gbox3d/bleuno/_forAI/plan.md

# Plan

## 목차

- [Current goal](#current-goal)
- [Near-term work](#near-term-work)
- [Structure decisions](#structure-decisions)
- [Risks](#risks)

## Current goal

사용자는 수업 구성을 뒤로 미루고 type_m 완성을 우선한다. 보고된 문제는 **USB로는 부팅되지만 배터리로는 부팅되지 않는 것**이며, 사용자는 먼저 KiCad 설계 자체를 검토·수정하라고 요청했다. 2026-11-01에 **v1.1 전원부 설계 오류 3건(BAT 극성 표시, J2 직렬 스위치, J1 이름)을 수정·검증했다.** 다음 세션은 아래 남은 결정과 실물 검증 준비부터 이어간다.

센서 배선과 전원부는 v1.1 설계 파일에서 수정 완료했고 펌웨어/앱은 1.1.0이다. 새 승압 회로 추가, 펌웨어 변경/업로드, PCB 제작은 수행하지 않았다. 설계 수정이 실장된 v1 보드를 고치지는 않는다.

## Near-term work

- [x] 2026-11-01 전원 설계 검토 자료를 읽고 KiCad 작업본을 확인했다.
- [x] 2026-11-01 **배터리 극성 표시 수정.** 실크 `BAT + -` → `BAT`(원위치) + 각 패드 바로 위 `−`(J1.2 GND)/`+`(J1.1) 0.8 mm. 패드 네트는 바꾸지 않았다.
- [x] 2026-11-01 **전원 스위치 직렬화.** J1.1 VCC→VIN, J2.3(VIN)으로 1.0 mm 배선 추가, VCC 노드로 가던 대각 배선 삭제, 회로도 #PWR012 제거·VIN 라벨·J2.1 NC. 결과 VIN={J1.1,J2.3}, VCC={J2.2,J5.1,J6.1,R1.1,U1.8,U2.9}.
- [x] 2026-11-01 **J1 값 `MT1`→`BAT`** (회로도·PCB).
- [x] 2026-11-01 수정 후 kicad-cli netlist/ERC/DRC(회로도 일치)·독립 대조 `verify_power_fix.py` 34/34 PASS. 규칙·핀 유형 완화 없음. CHKBAT 분압은 VCC 쪽 유지(ON이면 배터리 전압/2, OFF이면 무전류). 전후 그림 `validation/power-fix-2026-11-01/review.html`.
- [ ] **J2에 꽂을 부품을 정한다.** 소형 슬라이드 스위치(SS12D00 계열 0.3–0.5 A)는 모터·서보 피크 전류에 부족할 수 있다. 부하 전류 예산(DRV8833 모터 2개 + 서보 2개 + MCU)을 정하고, 그 전에는 2–3 쇼트 점퍼로 운용한다. 사용자에게 사양을 반복해 묻지 말고 먼저 부품 자료로 예산 초안을 만든다.
- [ ] **USB·배터리 동시 연결 정책을 정한다.** 판매자 매뉴얼은 모듈 5V 핀 입력 5 V±0.2 V·Type-C와 5V 핀 동시 급전 금지를 명시한다. 배터리 연결+스위치 ON 상태로 USB를 꽂지 않는 운용 규칙을 교재·앱 안내에 반영할지 결정한다. 모듈의 USB→5V 핀 경로는 KiCad에 없으므로 단정하지 않는다.
- [ ] **실장된 v1 보드의 처리를 정한다.** v1은 배터리가 VCC에 직결되고 SEN1이 미연결이다. 재제작(v1.1) 또는 임시 보수 중 무엇을 할지는 사용자 결정이며, 점퍼를 기본 절차처럼 요구하지 않는다.
- [ ] 전원 구성의 판정 한계: 3.7 V 직결 불가·승압 필수·실제 역극성·부품 손상을 현재 정보로 단정하지 않는다. 배터리 부팅 실패 원인은 미확정이다.
- [ ] 전원부 결정 뒤 DHT22 정상 수치 확인을 이어간다. 현재 DHT22는 SENSOR1에 연결됐으나 실제 수치 성공 기록은 없다.
- [ ] 남은 ERC 오류20(no_connect 미표시 미연결 핀 5: U1 GPIO2/8/9/21·U2 ULT, 전원 심볼 미구동 2: VCC·GND, 가져온 심볼의 Input 핀 유형 pin_not_driven 13)/경고26(pin_to_pin)과 실크 높이 DRC 경고12를 검토한다. 핀 유형을 실제 기능대로 고치거나 PWR_FLAG를 두는 것은 사용자 결정 뒤에 한다. 제작 출력·실물 부하·파형 검증은 완료로 표시하지 않는다.
- [ ] 제작 전 최종 점검: 제작 출력(Gerber/드릴) 생성과 BOM(J2 부품 포함) 정리. 그 뒤 모터 정지/방향·서보 파형/부하 확인 범위를 정한다.

## Structure decisions

- 현재 수정 작업본: `hardware/type_m/v1.1/kicad/type_m_v1_1.kicad_pro`. 원본 `hardware/type_m/v1/`과 원본 아카이브는 보존한다. **v1.1은 제작 전이므로 센서 배선과 전원부 수정을 같은 리비전으로 관리한다.** 센서 단계만의 스냅샷은 `validation/power-fix-2026-11-01/before-power-fix.*`에 있어 필요하면 v1.1(센서)/v1.2(전원)로 나눌 수 있다.
- v1.1 SEN1 배선: J7.2–R3.2–U1.15(GPIO20), 기존 J7 3.3V와 R3 10kΩ 유지. U1.16 이름은 GPIO21, 미연결이다. 하드웨어 리비전은 펌웨어 버전과 독립적이다.
- v1.1 전원부: 배터리 + → J1.1 → VIN → J2.3; J2.2(COM) → VCC → U1.8/U2.9/J5.1/J6.1/R1.1; J2.1 OFF/NC. CHKBAT 분압은 VCC 쪽. 설계 파일 수정은 스크립트(`patch_*_power.py`)로 적용했고 수정 전 해시와 다르면 재실행을 거부한다.
- 펌웨어: `src/type_m_main.cpp` / `include/type_m_protocol.hpp`, 별도 PlatformIO `type_m`, 버전1.1.0, DHT11/22. 기존 LED/DHT11 `src/main.cpp` 및 JSON Config와 혼합하지 않는다.
- Android 완성 앱: `C:\Users\user\Desktop\work\cronos\bleunoApp\TypeMControl`. 교재: `C:\Users\user\Desktop\work\teaching_repo\android_programming`. type_m 완성 이후 수업 배치·단계별 과제를 논의한다.
- type_s 작업은 보류다. 기존 이전 결과·R1/R2 값 차이는 보존한다.
- 이번 세션에서 외부 EasyEDA 원본은 수정하지 않았다. 후속 작업은 사용자 요청대로 KiCad를 우선한다. 제조 주문·게시·commit/push는 수행하지 않았다.

## Risks

- **사용자에게 작업을 시키기 전에 보드를 확인한다.** 사용자는 “키캐드만 보세요”, “시키지좀 마세요..보드 확인 부터 해요”라고 명시했다. 같은 측정·점퍼·배터리/부하 사양 질문을 반복하지 않는다.
- “배터리3.7V”와 이후 “4.9V가 나온다”는 보고가 있다. 측정 위치/전원 모듈 포함 여부는 미확정이다. 낮은 전압이 원인이라고 몰아가거나 승압 회로를 먼저 확정하지 않는다.
- BAT 실크의 극성 순서가 잘못됐지만 사용자의 실제 연결이 역극성이었는지는 미확정이다. BAT→U1 구리 배선은 존재하므로 전원 배선 누락이라고 설명하지 않는다.
- KiCad의 U1 전원 핀 이름과 PCB pad/net은 대응한다. 그러나 풋프린트에는 5V/GND/3V3 실제 모듈 핀 실크가 없고 모듈 내부 회로도 없다. 외부 실물 특성까지 확인했다고 주장하지 않는다.
- v1.1 센서 파일 수정은 실장된 v1을 자동 수리하지 않는다. 물리 보수 여부·정상 DHT 측정·부하 구동은 미확정이다.
- `normalize_import.py` 등 원본 이전용 스크립트를 후속 설계에 자동 재실행하지 않는다. `patch_pcb_sensor.py`는 이미 적용됐으며 재적용하지 않는다.
- Python은 기존 인터프리터+uv만 사용하고 자동 다운로드를 금지한다. 기존 Flash 백업과 미커밋 작업을 보존한다.
