gbox3d/bleuno/hardware/type_m/v1/pinmap.md

# BLEuno type_m v1 — 원본 회로와 핀맵

## 목차

- [확인 범위](#확인-범위)
- [부품 대응](#부품-대응)
- [MCU 핀맵](#mcu-핀맵)
- [DRV8833 모듈 핀맵](#drv8833-모듈-핀맵)
- [커넥터와 전원](#커넥터와-전원)
- [원본에서 확인한 미연결과 불확정 사항](#원본에서-확인한-미연결과-불확정-사항)
- [기존 교재와의 차이](#기존-교재와의-차이)

## 확인 범위

대상은 `MovingTarget` 프로젝트의 `MotorConT1` 보드다.
원본 [MovingTarget_MotorConT1_2026-10-31.epro](source/MovingTarget_MotorConT1_2026-10-31.epro)의 회로도 심볼·핀 좌표·NET 속성과 PCB의 PAD_NET 레코드를 읽었다.
실장 부품 12개, 부품 핀 52개의 네트 대응은 두 문서에서 일치했다. 보드의 별도 홀 패드 2개는 이 부품 핀 수에 포함하지 않는다.

이 문서의 핀 번호와 네트 이름은 **원본 설계에서 관찰한 값**이다. 실제 부품 핀아웃·전압 허용범위·제작 보드의 동작까지 검증한 값은 아니다.
KiCad 이전을 마쳤다. 참조명·라이브러리 연결과 가져오기 결과를 정리한 뒤 원본과 대조했으며, 회로 기능을 바꾸는 수정은 하지 않았다.
원본 설계의 전기적 미연결과 모듈 핀 표기 검토는 남아 있다. [README](README.md)와 [이전 비교 결과](validation/import-comparison.json)를 함께 확인한다.

이전 비교에서는 부품 12개·부품 패드 52개·트랙 118개·비아 0개·연결 네트 그룹 17개가 일치했다.
별도 홀 패드 2개는 KiCad에서 `MP1`, `MP2`로 관리한다. 이 수치 일치는 회로 동작이나 제작 가능성을 보증하지 않는다.

원본 내부 경로:

- `PCB/230020836b7d42a2ae0bd4e6ece12948.epcb`
- `SHEET/dd2cfae3a64d4b3db5dd5a512ac44bc2/1.esch`
- MCU 심볼: `SYMBOL/ef7b01f3d1c740a3922ade97e6567549.esym`
- 드라이버 심볼: `SYMBOL/05bd6a162ddc49aa8801eba8ecf4b81c.esym`

## 부품 대응

원본 참조명에는 중복·공백·개행이 있다. 아래 표는 KiCad에서 정리한 참조명과 원본 이름의 대응이다.

| 원본 이름 | KiCad 정리 대응명 | 역할 |
|---|---|---|
| Tenstar | U1 | ESP32-C3 Supermini 모듈 |
| DRV8833 | U2 | 12핀 모터 드라이버 모듈 |
| 220k — VCC 쪽 | R1 | VCC와 CHKBAT 사이 220kΩ |
| 220k — GND 쪽 | R2 | CHKBAT와 GND 사이 220kΩ |
| 10k | R3 | 3.3V와 SEN1 사이 10kΩ 풀업. `project.json`의 라이브러리 기본값을 상속 |
| BAT + - | J1 | 전원 커넥터 |
| PW OFF ON | J2 | 3핀 헤더 |
| MT1 | J3 | 모터 출력 1 |
| MT2 | J4 | 모터 출력 2 |
| Servo1 | J5 | 서보 출력 1 |
| Servo2 | J6 | 서보 출력 2 |
| sensor1 | J7 | 센서용 3핀 커넥터 |

## MCU 핀맵

`Tenstar` 모듈의 **심볼·풋프린트 핀 번호**를 기준으로 한다. ESP32-C3 칩 패키지의 핀 번호가 아니다.

| 모듈 핀 | 원본 심볼 이름 | 네트 | 연결 |
|---|---|---|---|
| 1 | GPIO0 | CHKBAT | 배터리 전압 감지용 분압 중간점 |
| 2 | GPIO1 | D1 | DRV8833 모듈 pin7, IN1 |
| 3 | GPIO2 | 없음 | 미연결 |
| 4 | GPIO3 | D2 | DRV8833 모듈 pin8, IN2 |
| 5 | GPIO4 | D3 | DRV8833 모듈 pin11, IN3 |
| 6 | +3V3 | 3.3V | sensor1 전원과 R3 풀업 |
| 7 | GND | GND | 공통 접지 |
| 8 | +5V | VCC | 배터리·드라이버·서보 전원과 같은 네트 |
| 9 | GPIO5 | D4 | DRV8833 모듈 pin12, IN4 |
| 10 | GPIO6 | SERVO1 | Servo1 pin2 |
| 11 | GPIO7 | SLEEP | DRV8833 모듈 pin1 |
| 12 | GPIO8 | 없음 | 미연결 |
| 13 | GPIO9 | 없음 | 미연결 |
| 14 | GPIO10 | SERVO2 | Servo2 pin2 |
| 15 | GPIO21 | 없음 | 미연결. 실제 모듈 핀 이름 대조 필요 |
| 16 | GPIO22 | 없음 | 원본 심볼의 표기. 실제 모듈 핀 이름 대조 필요 |

`GPIO22`라는 문자열은 원본 심볼에서 그대로 옮긴 것이며 실제 ESP32-C3 모듈의 GPIO로 확정하지 않는다.
원본에 함께 들어 있는 다른 Supermini 심볼은 이 보드에 사용되지 않았으므로 대체 근거로 삼지 않았다.

## DRV8833 모듈 핀맵

이 심볼은 **12핀 모듈**이다. DRV8833 IC 단품 심볼로 바꾸면서 같은 번호를 적용하면 안 된다.
`EEP`, `ULT`는 원본에 적힌 핀 이름이며 실제 모듈의 SLEEP·FAULT 표시와 대조가 필요하다.

| 모듈 핀 | 원본 핀 이름 | 네트 | 연결 |
|---|---|---|---|
| 1 | EEP | SLEEP | MCU GPIO7 |
| 2 | OUT1 | OUT1 | MT1 pin1 |
| 3 | OUT2 | OUT2 | MT1 pin2 |
| 4 | OUT3 | OUT3 | MT2 pin1 |
| 5 | OUT4 | OUT4 | MT2 pin2 |
| 6 | ULT | 없음 | 미연결 |
| 7 | IN1 | D1 | MCU GPIO1 |
| 8 | IN2 | D2 | MCU GPIO3 |
| 9 | VCC | VCC | 전원 |
| 10 | GND | GND | 공통 접지 |
| 11 | IN3 | D3 | MCU GPIO4 |
| 12 | IN4 | D4 | MCU GPIO5 |

## 커넥터와 전원

핀 순서는 위에서 내려다본 좌우 순서가 아니라 원본 풋프린트의 **패드 번호**다. 실물 극성은 커넥터 방향과 함께 확인한다.

| 원본 커넥터 | KiCad 대응명 | pin1 | pin2 | pin3 |
|---|---|---|---|---|
| BAT + - | J1 | VCC | GND | — |
| PW OFF ON | J2 | 미연결 | VCC | VIN |
| MT1 | J3 | OUT1 | OUT2 | — |
| MT2 | J4 | OUT3 | OUT4 | — |
| Servo1 | J5 | VCC | SERVO1 | GND |
| Servo2 | J6 | VCC | SERVO2 | GND |
| sensor1 | J7 | 3.3V | SEN1 | GND |

BAT·MT1·MT2는 원본 부품 메타데이터에서 `BX-ZH1.5-2PWZ`, sensor1은 `WAFER-ZH1.5-3PZZ`다.
PW OFF ON·Servo1·Servo2는 `HDR-M_2.54_1x3P`다.

VCC는 배터리 pin1, MCU의 `+5V` 표기 핀, 드라이버 VCC, 두 서보 전원, R1을 연결한다.
`+5V`는 심볼의 핀 이름일 뿐, 실제 VCC가 5V로 조정된다는 의미는 아니다. 이 마더보드 원본에는 별도의 전원 레귤레이터·충전 IC가 없다.

CHKBAT는 VCC와 GND 사이 220kΩ 두 개의 중간점이다.
동일 저항값으로 계산한 무부하 분압비는 `CHKBAT = VCC / 2`다. ADC 입력 조건·실측 전압·허용 배터리 범위는 별도 확인한다.

## 원본에서 확인한 미연결과 불확정 사항

1. **SEN1은 MCU 미연결이다.** sensor1 pin2와 R3만 연결되며 PCB도 이 두 부품 사이만 배선되어 있다. 센서 커넥터가 있다는 이유만으로 DHT11을 읽을 수 있는 상태가 아니다.
2. **VIN은 PW OFF ON pin3에만 연결된다.** 다른 부품·트랙으로 이어지지 않는다. 반면 배터리 VCC는 각 부하에 직결되므로 이 헤더를 전체 전원 차단 스위치로 설명하면 안 된다.
3. MCU pin15·16의 실제 핀 명칭, 특히 원본 `GPIO22` 표기는 실물 모듈과 대조해야 한다.
4. 모듈 내부 회로, USB 전원과 외부 전원 관계, 커넥터 허용 전류·극성은 이 원본만으로 확정하지 않았다.

위 항목은 원본 회로도·PCB에서 공통으로 관찰했다. KiCad 가져오기 과정에서 새로 생긴 문제로 분류하지 않는다.

## 기존 교재와의 차이

기존 교재 SmartIO는 LED 4개와 DHT11을 대상으로 설명한다. 이 V1 원본은 모터·서보용이므로 기존 실습을 바로 적용하지 않는다.

- 기존 `ledpin = [4,3,1,0]`을 적용하면 GPIO0의 CHKBAT 분압 입력까지 출력으로 사용한다. 이 설정을 V1에 그대로 넣지 않는다.
- 기존 `dht11pin = 7`은 GPIO7의 드라이버 SLEEP 제어와 충돌한다. SEN1도 MCU에 연결되어 있지 않다.
- 원본 D1·D2·D3·D4에 대응하는 GPIO 순서는 `[1,3,4,5]`지만, 이 목록만으로 모터용 펌웨어 설정을 확정하지 않는다. 드라이버 활성화·입출력 의미·정지 동작을 함께 검증해야 한다.
- 기존 펌웨어의 `pwm`은 LED 밝기용 설정을 사용한다. 서보 헤더가 있다는 사실만으로 각도 제어 명령이 구현되었다고 보지 않는다.
- 수업 앱과 Fake 모드는 기존 흐름을 유지한다. 모터·서보 실습을 추가할 때는 검증된 보드 설정과 앱 제어 화면을 함께 설계한다.

Android 빌드, 실제 BLE 연결, 모터·서보·센서 구동은 아직 검증하지 않았다.
