gbox3d/bleuno/hardware/type_m/v1.1/validation/preview/type_m_v1_1-schematic.png

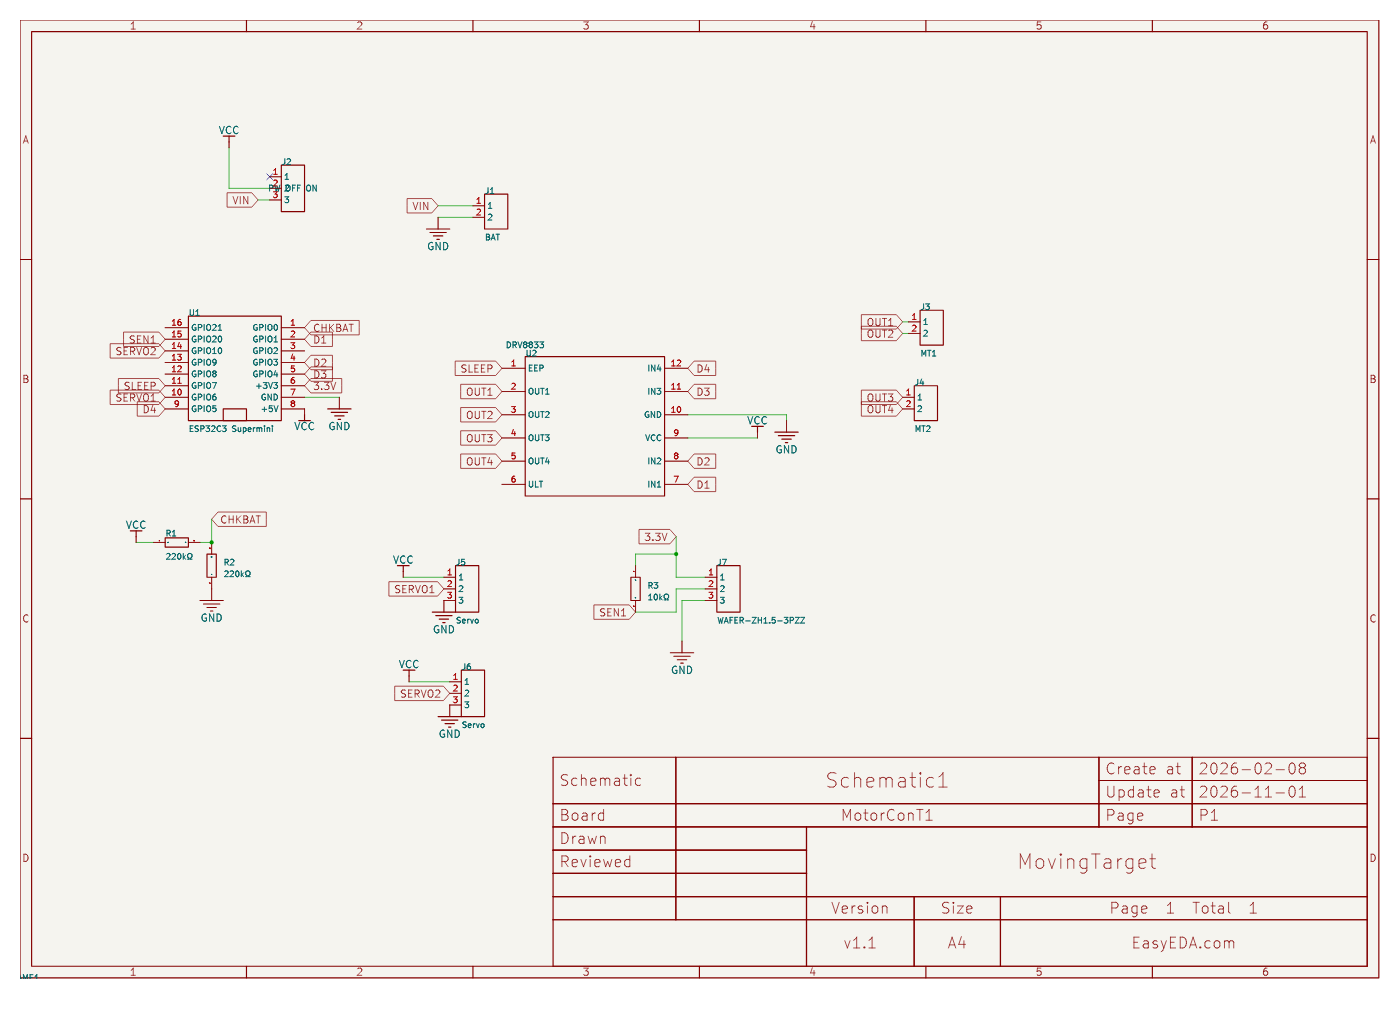
hardware/type_m/v1.1/validation/preview/type_m_v1_1-schematic.png
