gbox3d/bleuno/hardware/type_m/v1.1/validation/power-audit-2026-11-01/battery-polarity-review.html

# KiCad 전면 PCB: 배터리 인쇄와 실제 극성이 반대 (수정 전 검토)

기록 안내(2026-11-01 후속): 이 페이지는 ../preview/type_m_v1_1-pcb.svg를 직접 포함하므로 전원부 수정 이후에는 수정 후 실크(BAT − +)가 보입니다. 수정 전 상태의 고정 그림은 battery-polarity-review.png이고, 수정 내용은 전원부 수정 확인 화면에 있습니다.

아래는 KiCad가 내보낸 PCB SVG의 배터리 부분 확대입니다. 이 검토 시점에는 그림 안의 인쇄·배선을 수정하지 않았습니다.

전면에서 본 위치 | KiCad 패드 | 실제 연결
왼쪽 원형 패드 | J1.2 | GND = 배터리 −
오른쪽 사각 패드 | J1.1 | VCC = 배터리 +

실크의 순서는 “+ −”, 실제 패드의 좌우 순서는 “− +”입니다.

저장된 type_m v1.1 KiCad 설계 기준입니다. 실제 케이블 극성이나 실물 고장의 원인을 확정하는 자료는 아닙니다.
