gbox3d/bleuno/hardware/type_m/v1.1/validation/preview/review.html

# type_m v1.1 · SENSOR1 연결 확인

SENSOR1 가운데 신호 핀을 C3의 GPIO20에 PCB 배선으로 연결했습니다.

센서 단계(2026-11-01 1단계) 기록입니다. 이 페이지의 바탕 그림은 현재 파일에서 다시 내보낸 SVG라 같은 날 2단계 전원부 수정(J1 BAT − + 표시, J1.1 → VIN)도 함께 보입니다. 전원부 수정 내용과 현재 검사 수치(ERC 오류 20·경고 26)는 전원부 수정 확인 화면을 참조하세요.

## PCB에서 확인할 위치

추가한 앞면 배선추가한 뒷면 배선기존 SENSOR1 배선

KiCad가 내보낸 실제 PCB SVG 위에 배선 색과 번호를 설명용으로 겹쳤습니다. 강조선은 보기 쉽게 굵게 표시했습니다. 실제 새 배선 폭은 0.254 mm입니다.

① C3의 ‘20’ 핀
U1 왼쪽 열 아래에서 두 번째 패드입니다. 모듈 패드 번호는 15이고 GPIO 번호는 20입니다.

② 앞면 → 뒷면
추가한 비아에서 뒷면으로 넘어가 기존 SEN1 배선에 연결됩니다.

③ SENSOR1 신호
커넥터 가운데 핀입니다. 기존 R3 풀업 연결도 유지됩니다.

## 회로도에서도 같은 연결입니다

J7.2 ↔ R3.2 ↔ U1.15(GPIO20) 세 핀이 같은 SEN1 네트에 속합니다. 아래 회로도에서 U1의 GPIO20 옆과 SENSOR1 가운데 핀에 있는 SEN1 라벨을 확인하세요.

수정한 type_m v1.1 전체 회로도

## 검사 결과와 남은 확인

PCB DRC 오류 0미배선 0회로도 / PCB 불일치 0

기존 실크 글자 높이 경고 12개는 남아 있습니다. 회로도 ERC는 센서 단계 당시 오류 21개·경고 27개였고, 전원부 수정 후 현재는 오류 20개·경고 26개입니다. 원본 v1 파일 57개를 보존했으며 센서 단계에서는 기존 부품 위치·배선·외곽을 유지했습니다(이후 전원부 수정으로 J1.1 네트와 VCC 배선 일부가 바뀜).

GPIO20은 UART0 RX 겸용이 맞습니다. 현재 펌웨어는 GPIO18/19의 USB 시리얼을 사용하므로 GPIO20을 DHT 입력으로 쓸 수 있습니다. GPIO20에 외부 UART를 함께 연결하지 않습니다.

이것은 새 PCB용 수정 설계입니다. 이미 실장된 v1의 배선이 바뀌지는 않으며, v1.1 제작 및 실제 센서 측정은 아직 확인하지 않았습니다.
