gbox3d/bleuno/hardware/type_m/v1.1/validation/power-audit-2026-11-01/battery-polarity-review.png

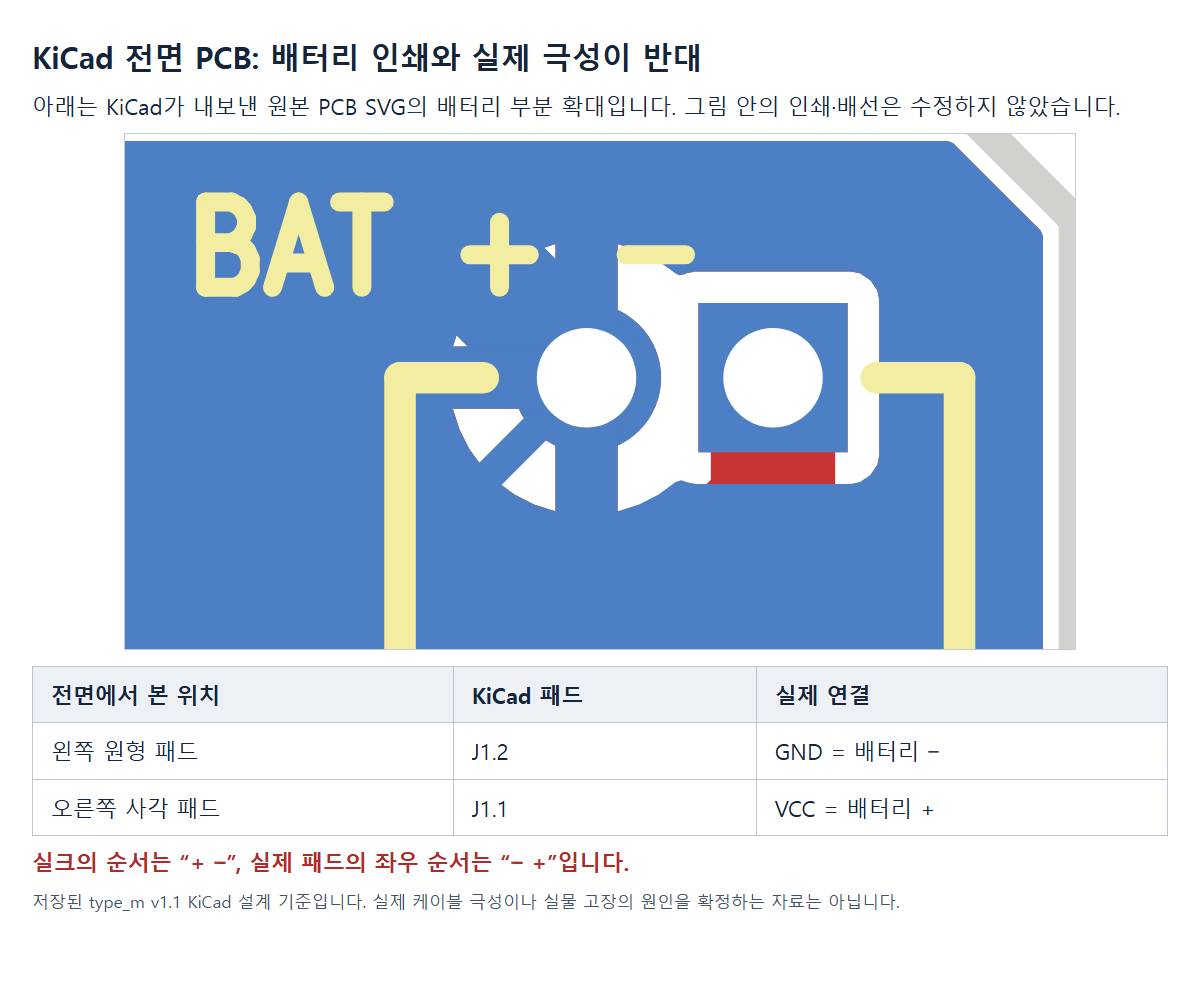
hardware/type_m/v1.1/validation/power-audit-2026-11-01/battery-polarity-review.png
