gbox3d/bleuno/hardware/type_m/v1.1/validation/preview/type_m_v1_1-pcb.png

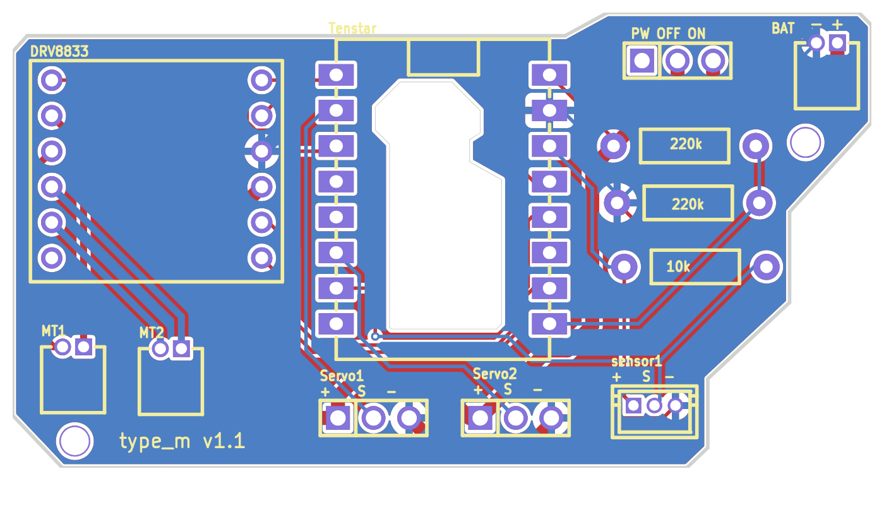
hardware/type_m/v1.1/validation/preview/type_m_v1_1-pcb.png
