gbox3d/bleuno/hardware/type_m/v1.1/validation/power-fix-2026-11-01/power-fix-review.png

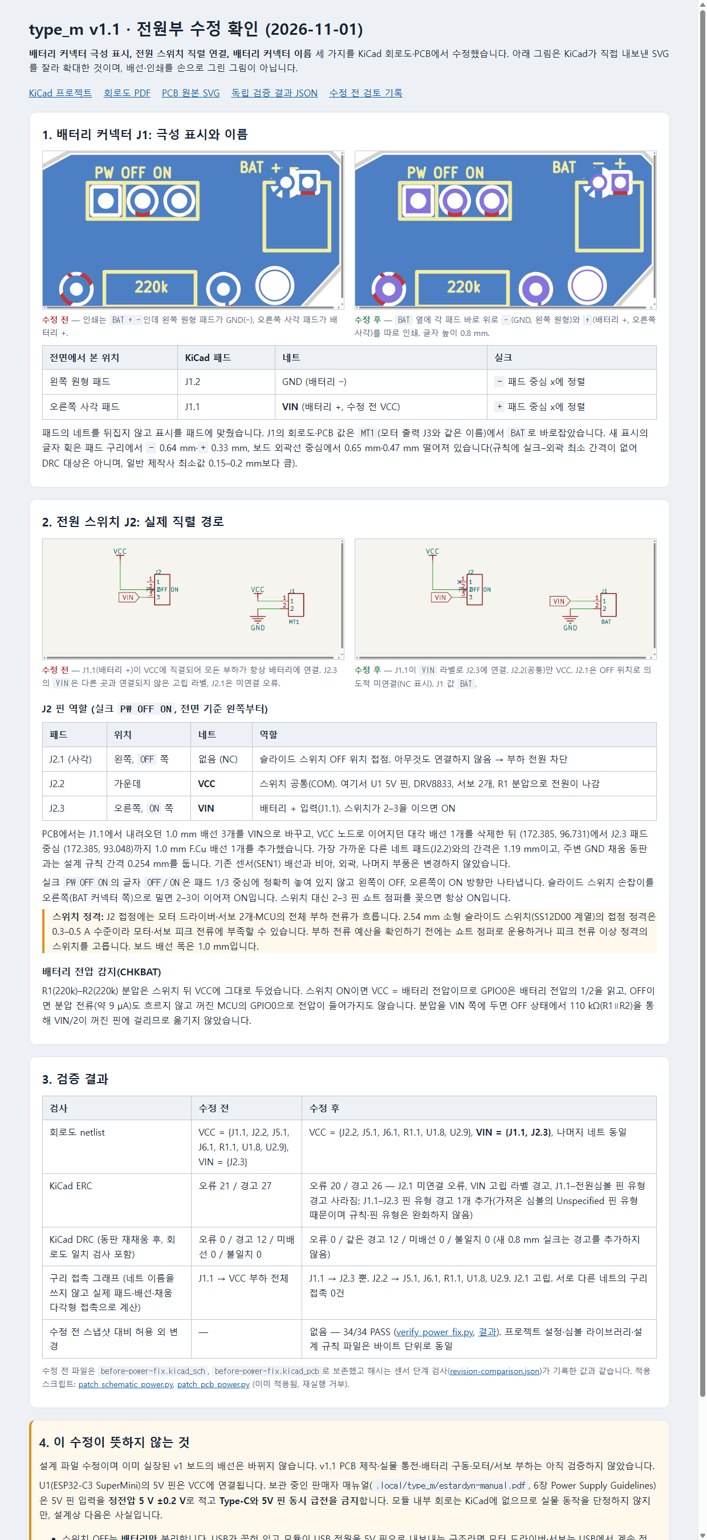
hardware/type_m/v1.1/validation/power-fix-2026-11-01/power-fix-review.png
