gbox3d/bleuno/hardware/type_m/v1.1/validation/preview/type_m_v1_1-schematic.pdf

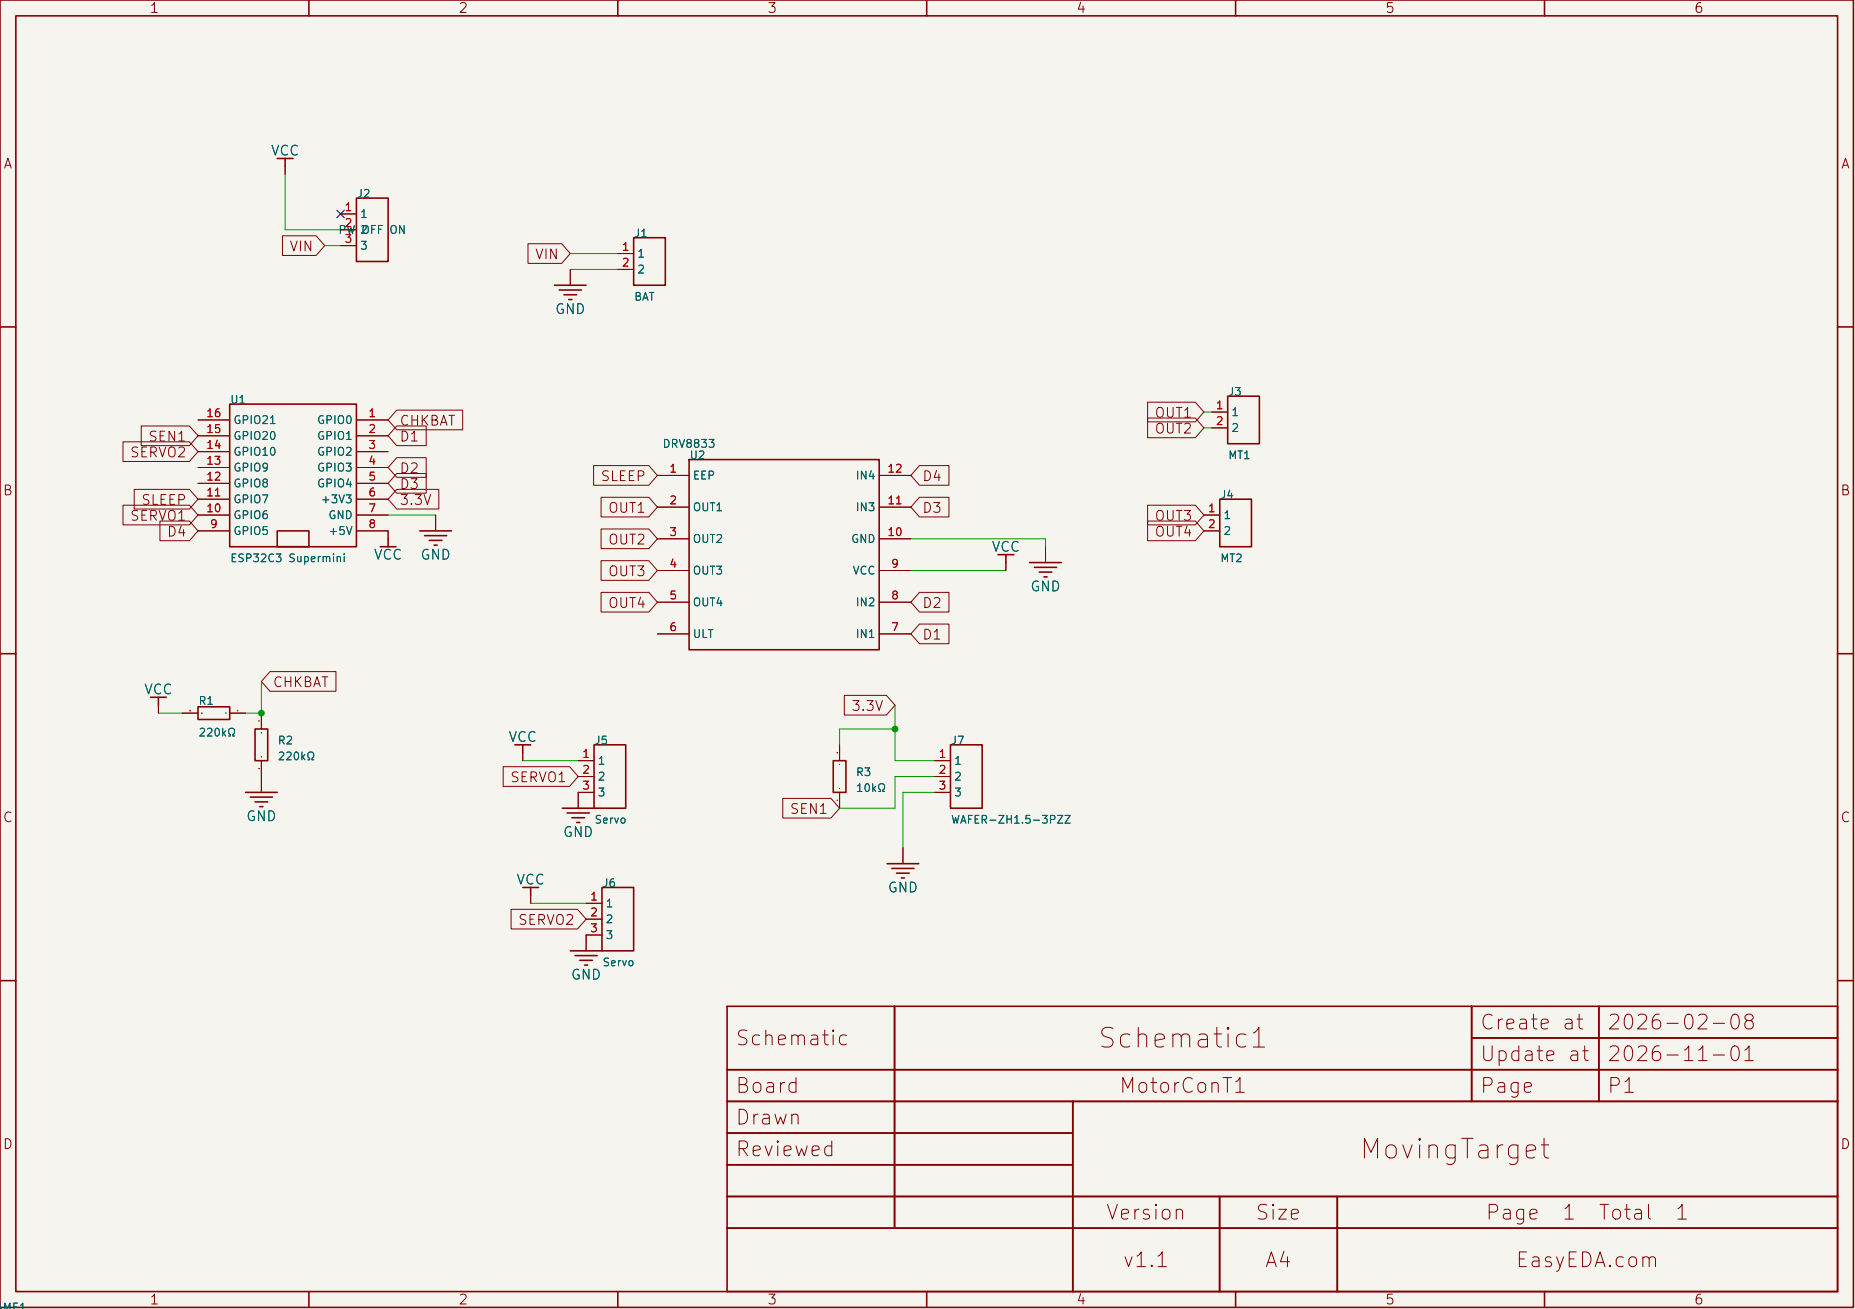
[picture p10: page 1]

Schematic | Schematic1 | Create at | 2026-02-08

Update at | 2026-11-01

Board | MotorConT1 | Page | P1
Drawn | | MovingTarget
Reviewed

Version | Size | Page 1 Total 1

v1.1 | A4 | EasyEDA.com
