gbox3d/bleuno/(list of files, drawings)

Other design files:
hardware/type_m/v1.1/validation/pcb-patch.json
hardware/type_m/v1.1/validation/power-fix-2026-11-01/pcb-power-patch.json
hardware/type_m/v1.1/validation/power-fix-2026-11-01/schematic-patch.json
hardware/type_m/v1/source/MovingTarget_MotorConT1_2026-10-31.epro
hardware/type_m/v1/validation/easyeda-baseline.json
hardware/type_s/v1/source/ZeroFactorySensorBoard_Board_DHT_2026-11-01.epro
hardware/type_s/v1/validation/easyeda-baseline.json
hardware/type_s/v1/validation/easyeda-designator-visibility.json
