gbox3d/bleuno/hardware/type_m/v1.1/validation/power-fix-2026-11-01/before-power-fix.kicad_pcb

## KiCad design hardware/type_m/v1.1/validation/power-fix-2026-11-01/before-power-fix.kicad_pcb (2026-11-09)

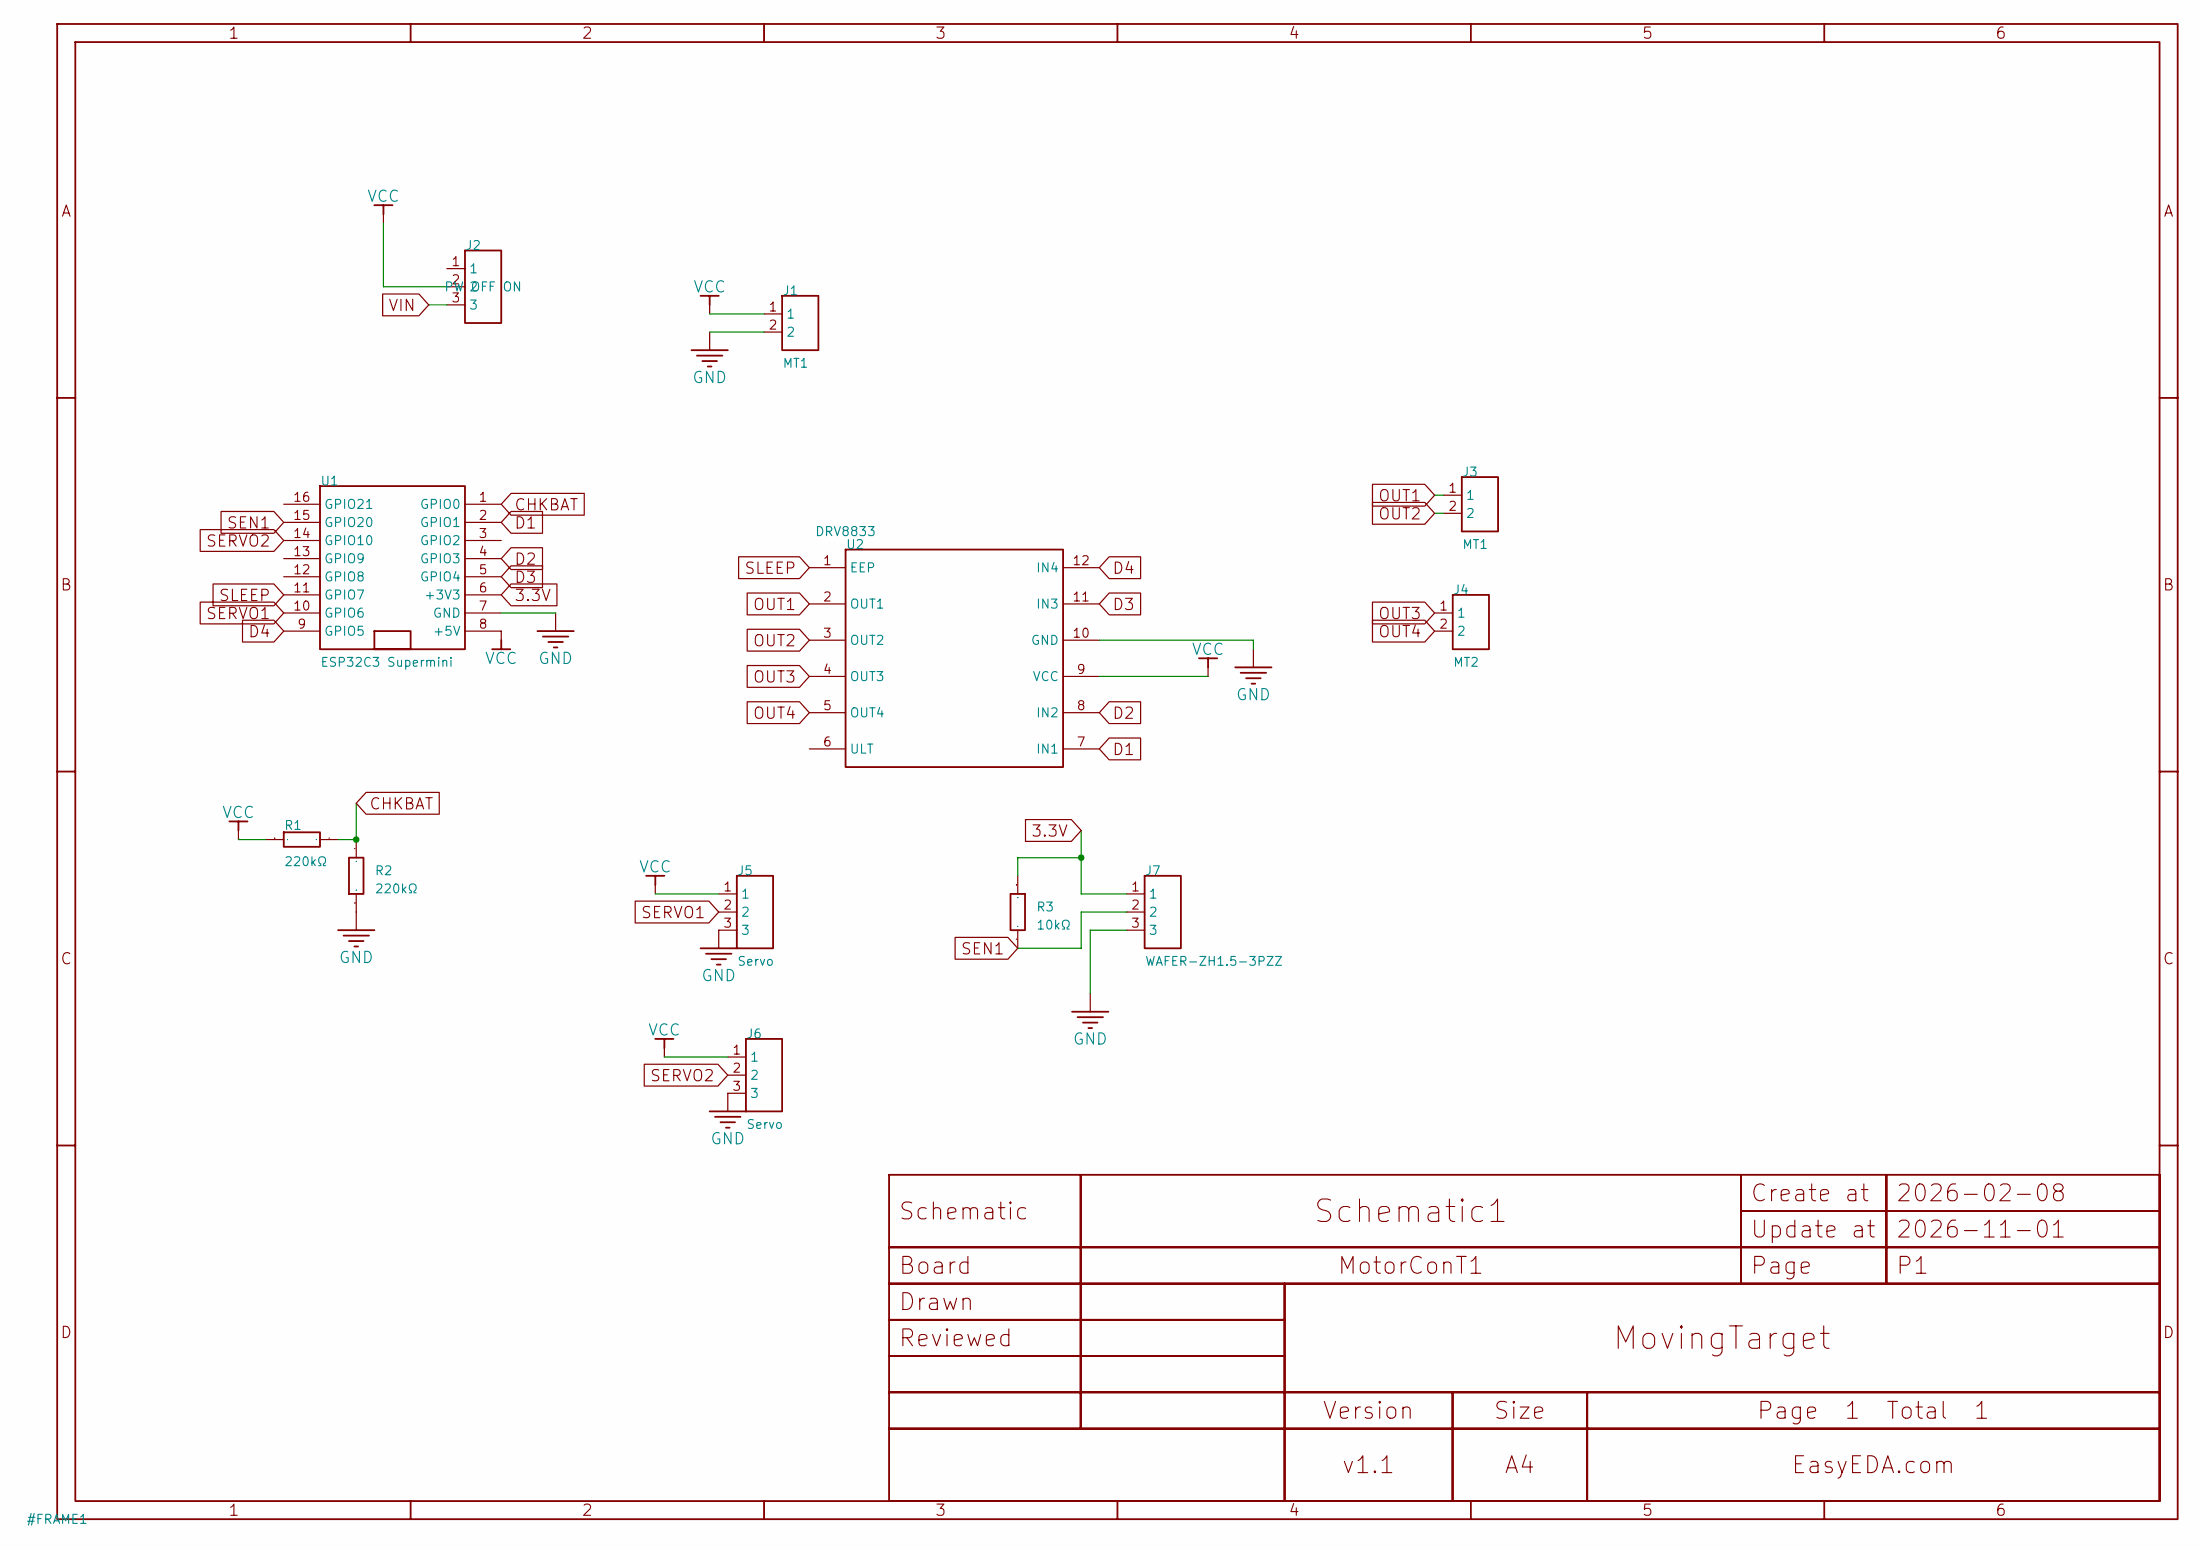
[picture p11: schematic before-power-fix.kicad_sch]

Parts:
J1, J3: MT1; CONN-TH_2P-P1.50_HCTL_HC-ZH1.5-2AW; Manufacturer Part BX-ZH1.5-2PWZ; LCSC Part Name 1x2P 间距:1.5mm 弯插 系列:ZH
J2: PW OFF ON; HDR-TH_3P-P2.54-V-M
J4: MT2; CONN-TH_2P-P1.50_HCTL_HC-ZH1.5-2AW; Manufacturer Part BX-ZH1.5-2PWZ; LCSC Part Name 1x2P 间距:1.5mm 弯插 系列:ZH
J5, J6: Servo; HDR-TH_3P-P2.54-V-M
J7: WAFER-ZH1.5-3PZZ; CONN-TH_3P-P1.50_A1500WV-03P; Manufacturer Part WAFER-ZH1.5-3PZZ; LCSC Part Name 1x3P 间距:1.5mm 直插 系列:ZH
R1, R2: 220kΩ; R_AXIAL-0.4
R3: 10kΩ; R_AXIAL-0.4
U1: ESP32C3 Supermini; ESP32C3 SM
U2: DRV8833

Connections:
3.3V: J7.1, R3.1, U1.6 (+3V3)
CHKBAT: R1.2, R2.2, U1.1 (GPIO0)
D1: U1.2 (GPIO1), U2.7 (IN1)
D2: U1.4 (GPIO3), U2.8 (IN2)
D3: U1.5 (GPIO4), U2.11 (IN3)
D4: U1.9 (GPIO5), U2.12 (IN4)
GND: J1.2, J5.3, J6.3, J7.3, R2.1, U1.7 (GND), U2.10 (GND)
OUT1: J3.1, U2.2 (OUT1)
OUT2: J3.2, U2.3 (OUT2)
OUT3: J4.1, U2.4 (OUT3)
OUT4: J4.2, U2.5 (OUT4)
SEN1: J7.2, R3.2, U1.15 (GPIO20)
SERVO1: J5.2, U1.10 (GPIO6)
SERVO2: J6.2, U1.14 (GPIO10)
SLEEP: U1.11 (GPIO7), U2.1 (EEP)
VCC: J1.1, J2.2, J5.1, J6.1, R1.1, U1.8 (+5V), U2.9 (VCC)
VIN: J2.3

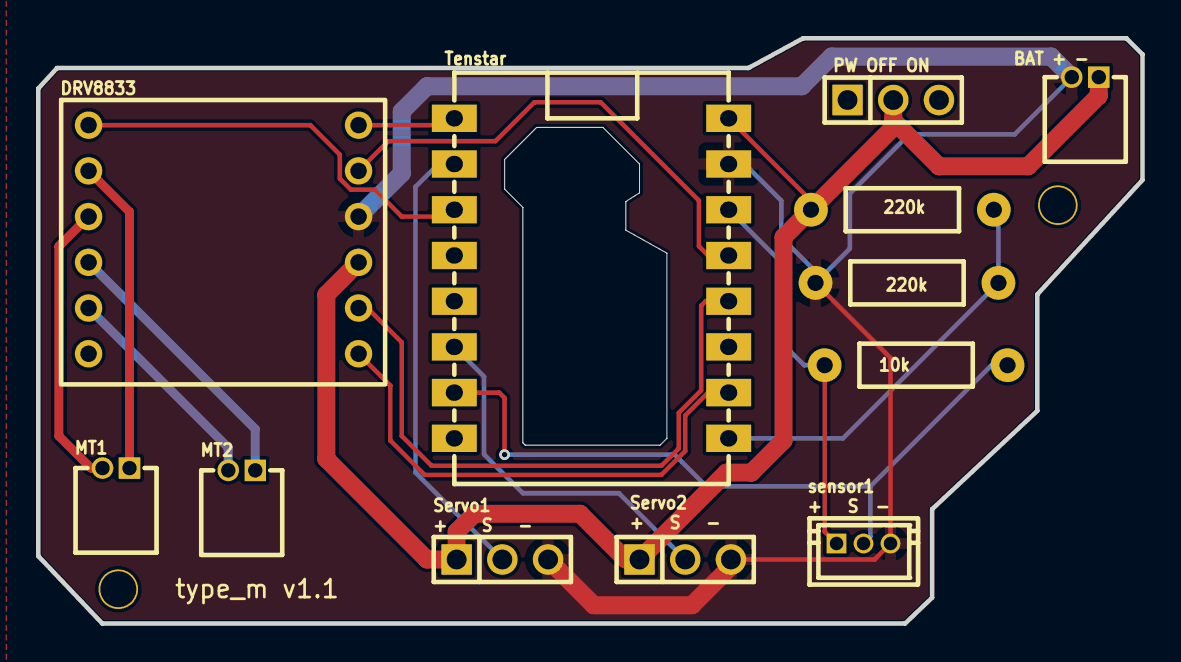
[picture p12: board before-power-fix.kicad_pcb from above]

Board: 2 copper layers, 61.3 x 32.5 mm, 14 parts (0 on the bottom side), 16 nets.

Other parts of the board:
MP1: Pad_e1
MP2: Pad_e2
