gbox3d/bleuno/hardware/type_s/v1/kicad/type_s_v1.kicad_pcb

## KiCad design hardware/type_s/v1/kicad/type_s_v1.kicad_pcb (2026-11-09)

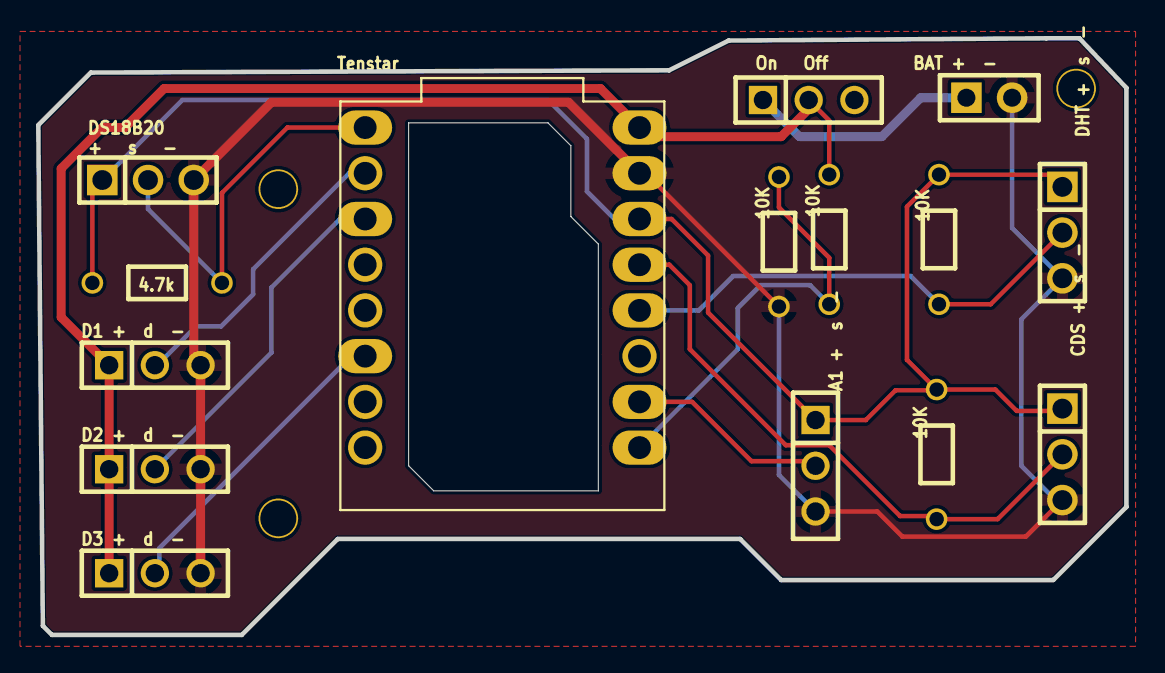
[picture p13: board type_s_v1.kicad_pcb from above]

Board: 2 copper layers, 60.5 x 33.1 mm, 18 parts (0 on the bottom side), 12 nets.

Parts:
J1: HDR-TH_2P-P2.54-V-F
J2, J6, J7, J8, J9: HDR-TH_3P-P2.54-V-F
J3, J4, J5: HDR-TH_3P-P2.54-V-M
MP1: Pad_e1
MP2: Pad_e2
MP3: Pad_e3
R1, R2, R3, R4: 10kΩ; RES-TH_BD1.8-L3.2-P7.20-D0.4
R5: R; RES-TH_BD1.8-L3.2-P7.20-D0.4
U1: ESP32-C3; ESP32C3_SUPERMINI_CUSTOM

Connections:
3.3V: J3.1, J4.1, J5.1, J6.1, R3.1, R4.1, R5.2, U1.3.3
5V: J2.2, J7.1, J8.1, J9.1, R1.1, U1.5V
A1: J6.2, U1.1
BATCHK: R1.2, R2.1, U1.0
D1: J7.2, U1.6
D2: J8.2, U1.7
D3: J9.2, U1.10
GND: J1.2, J3.3, J4.3, J5.3, J6.3, J7.3, J8.3, J9.3, R2.2, U1.G
SENSOR1: J3.2, R3.2, U1.3
SENSOR2: J4.2, R4.2, U1.4
SENSOR3: J5.2, R5.1, U1.5
VCC: J1.1, J2.1
