gbox3d/bleuno/include/tonkey.hpp

#ifndef TONKEY_HPP
#define TONKEY_HPP

#define MAXTOKENS 64

class tonkey {
private:
    String mTokens[MAXTOKENS];
    int mTokenCount = 0;

public:
    tonkey() {}
    ~tonkey() {}

    inline void parse(String _strLine) {
        int StringCount = 0;
        while (_strLine.length() > 0) {
            int index = _strLine.indexOf(' ');
            if (index == -1) {
                mTokens[StringCount++] = _strLine;
                break;
            } else {
                mTokens[StringCount++] = _strLine.substring(0, index);
                _strLine = _strLine.substring(index + 1);
            }
        }
        mTokenCount = StringCount;
    }

    inline int getTokenCount() const { return mTokenCount; }
    inline String getToken(int _index) const { return mTokens[_index]; }
};

#endif // TONKEY_HPP
