gbox3d/bleuno/(commit log)

2024-12-10 off 다음에 여러개 번호예
2024-12-10 c3xiao builtin led define
2024-12-10 pwm pin 지원
2025-01-05 pwm return msg
2026-11-09 type_m 펌웨어·하드웨어 v1/v1.1·type_s v1 설계 자료 추가
    - type_m 전용 펌웨어(src/type_m_main.cpp, include/type_m_protocol.hpp)와 PlatformIO type_m 환경: 모터 2·서보 2 제어, CCCD/about/ready 절차, STOP·1500ms watchdog, 1.1.0 DHT11/DHT22 지원
    - 호스트 테스트(tests/type_m_tests.cpp)와 BLE 점검 도구(tools/type_m_smoke.py, type_m_status.py)
    - hardware/type_m/v1: EasyEDA 원본(MovingTarget/MotorConT1) 보존, KiCad 이전·원본 대조, 핀맵
    - hardware/type_m/v1.1: SEN1-GPIO20 배선 추가, 배터리 극성·전원 스위치 J2 직렬 경로 수정과 검증 자료
    - hardware/type_s/v1: ZeroFactorySensorBoard 원본 보존·KiCad 이전·핀맵
    -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
